faxxxan/WALL-B/src/modules/display/images/chatgpt_eye2.png

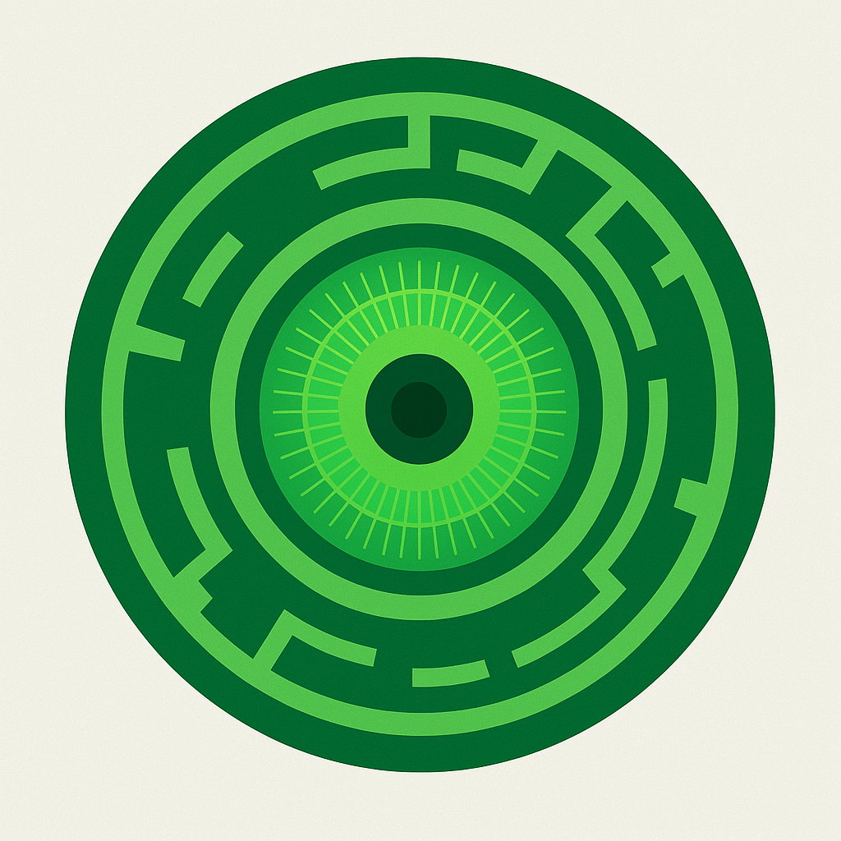
src/modules/display/images/chatgpt_eye2.png
