faxxxan/WALL-B/src/modules/display/images/chatgpt_eye3.png

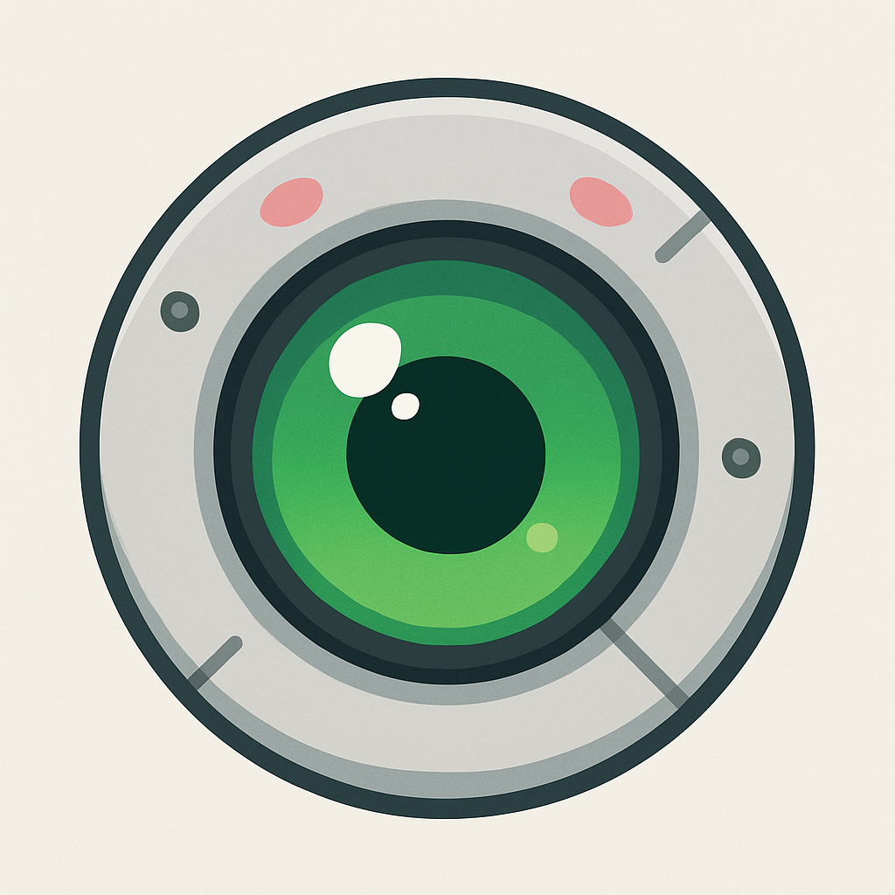
src/modules/display/images/chatgpt_eye3.png
