faxxxan/WALL-B/circuits/archie/Lower/Lower Feb 2021_pcb.png

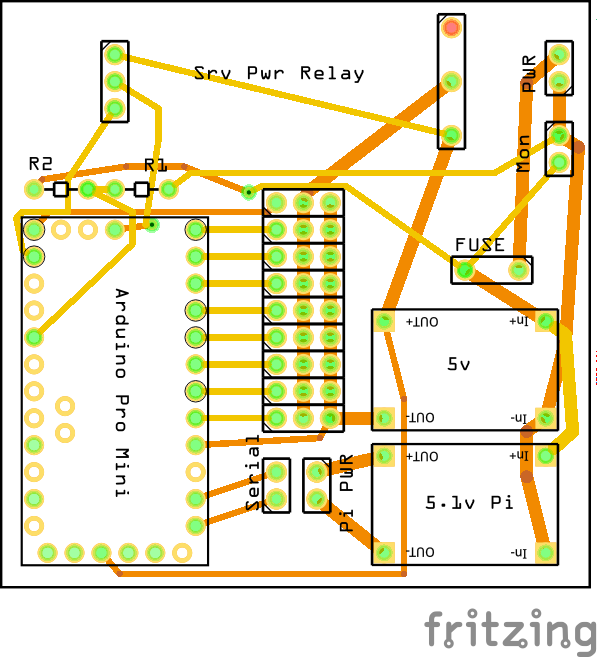
circuits/archie/Lower/Lower Feb 2021_pcb.png
