faxxxan/WALL-B/circuits/archie/Lower/Screenshot 2021-02-15 at 19.20.31.png

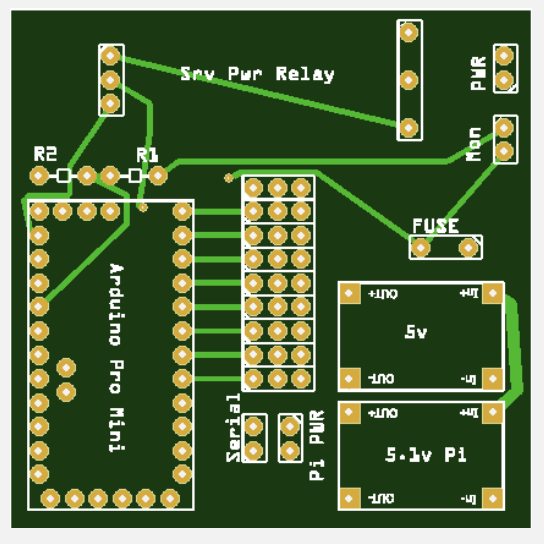
circuits/archie/Lower/Screenshot 2021-02-15 at 19.20.31.png
