faxxxan/WALL-B/circuits/archie/Upper/Screenshot 2021-02-15 at 19.52.01.png

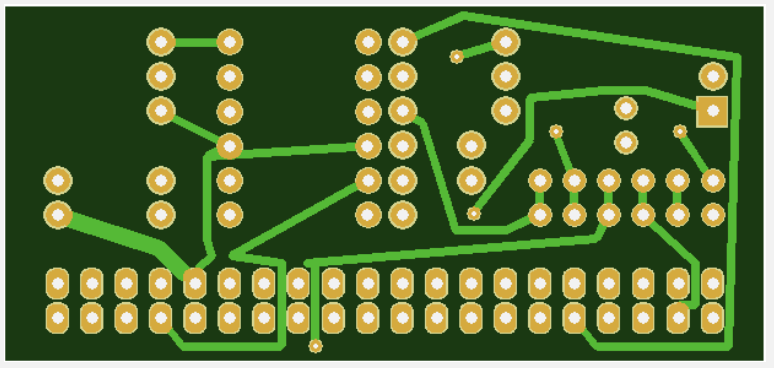
circuits/archie/Upper/Screenshot 2021-02-15 at 19.52.01.png
