faxxxan/WALL-B/circuits/archie/Upper/Top Feb 2021_pcb.png

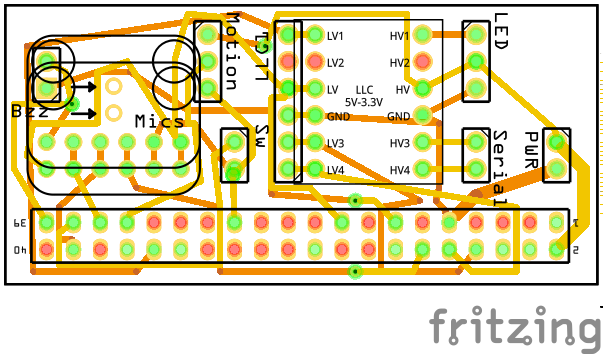
circuits/archie/Upper/Top Feb 2021_pcb.png
