faxxxan/WALL-B/circuits/buddy/body/body_pcb.png

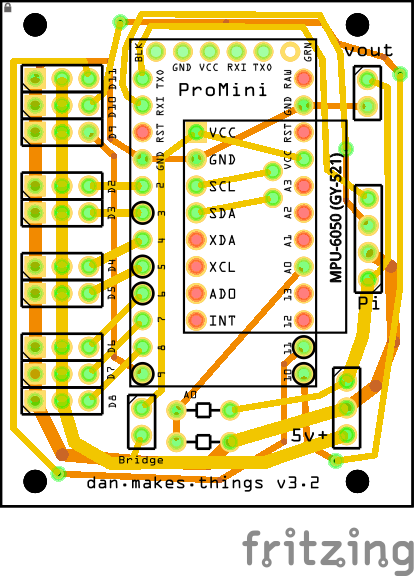
circuits/buddy/body/body_pcb.png
