faxxxan/WALL-B/circuits/buddy/head/head_schematic.png

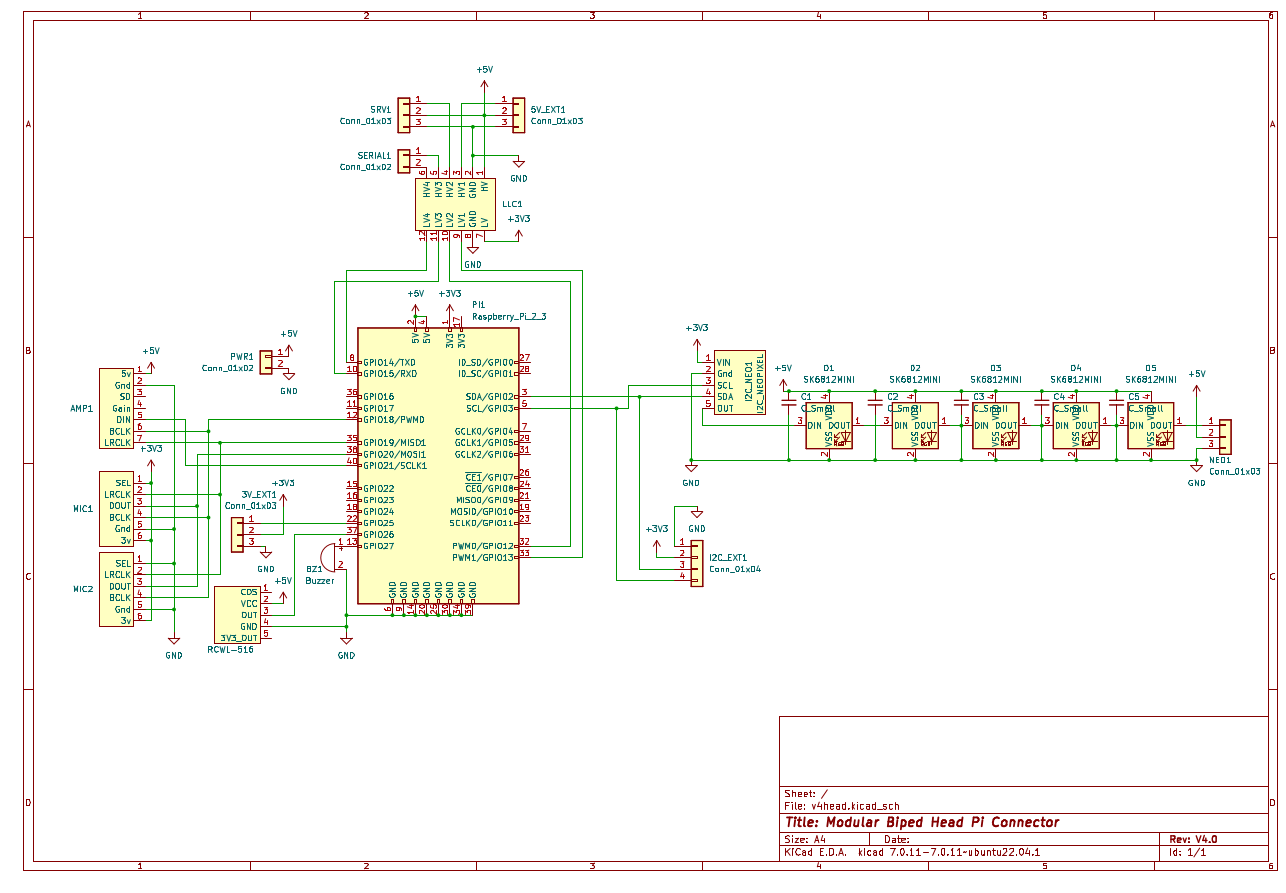
circuits/buddy/head/head_schematic.png
