faxxxan/WALL-B/images/d.jpeg

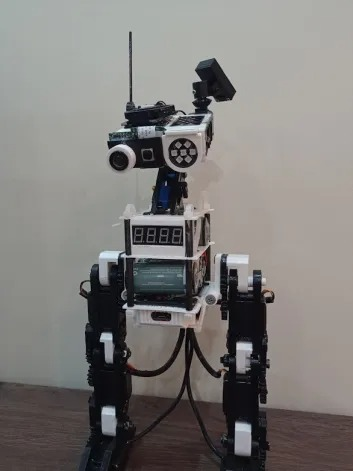
images/d.jpeg
