faxxxan/WALL-B/src/modules/display/images/chatgpt_eye1.png

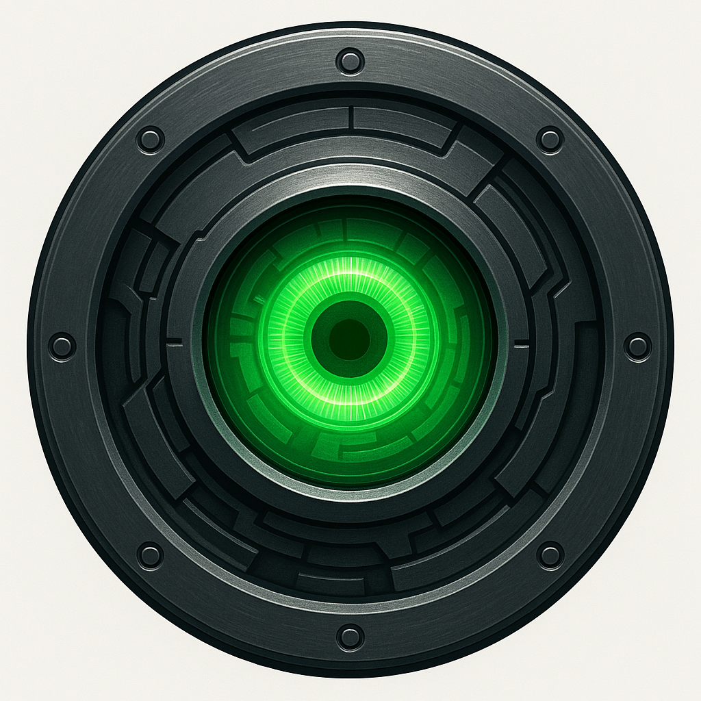
src/modules/display/images/chatgpt_eye1.png
