faxxxan/WALL-B/src/modules/display/images/chatgpt_eye4.png

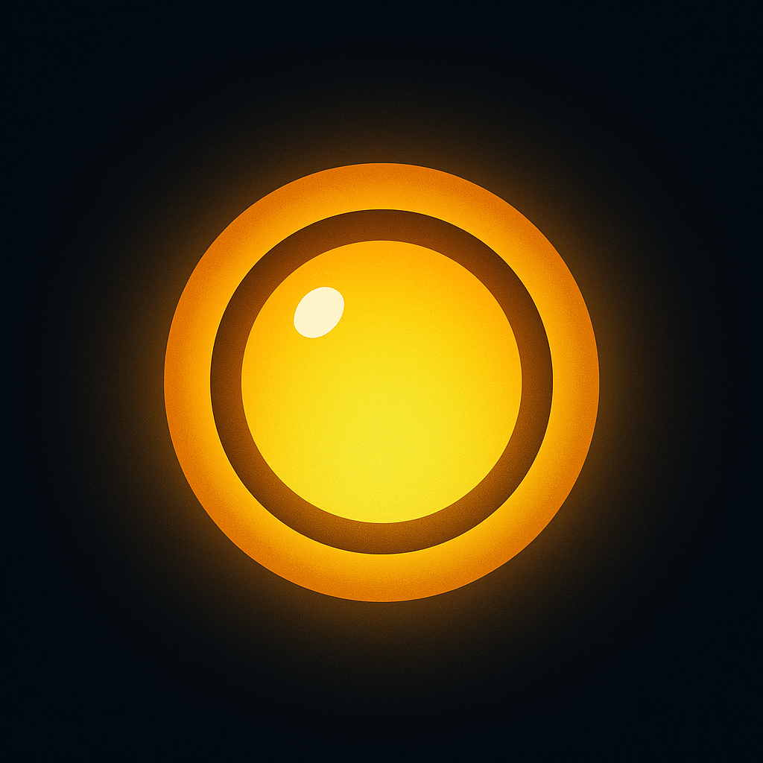
src/modules/display/images/chatgpt_eye4.png
