faxxxan/WALL-B/user_input_files/image.png

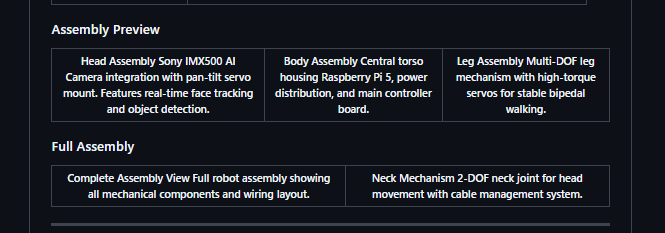
user_input_files/image.png
