faxxxan/WALL-B/3d_prints/archie/Complete (Reference).stl

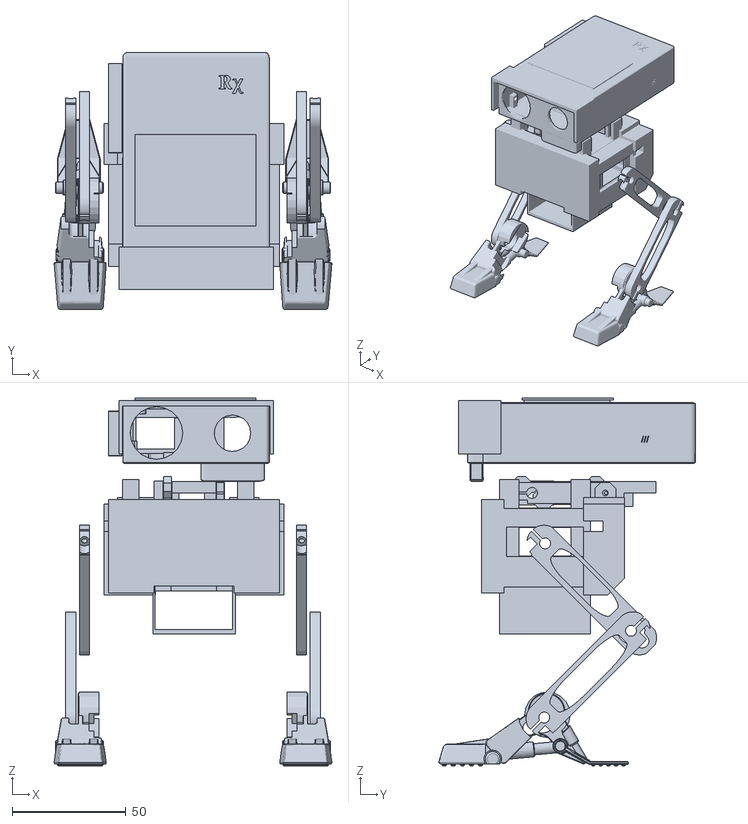
[picture p15: CAD file, 2026-03-01]
3d_prints/archie/Complete (Reference).stl
122.0 x 112.7 x 161.6
