faxxxan/WALL-B/3d_prints/archie/Archie - Head Lid.stl

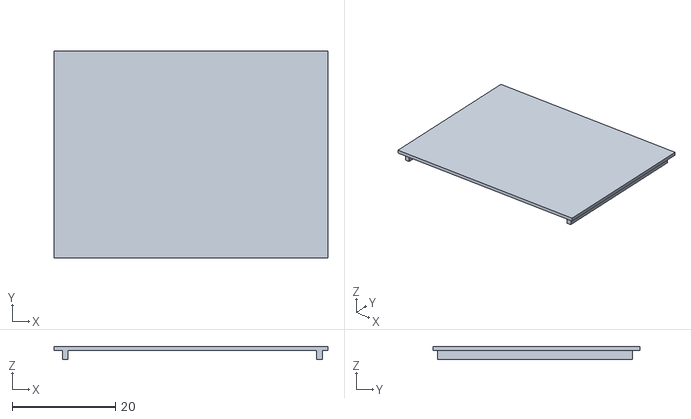
[picture p16: CAD file, 2026-03-01]
3d_prints/archie/Archie - Head Lid.stl
53.1 x 40.2 x 2.60
