faxxxan/WALL-B/3d_prints/archie/Archie - Foot Left.stl

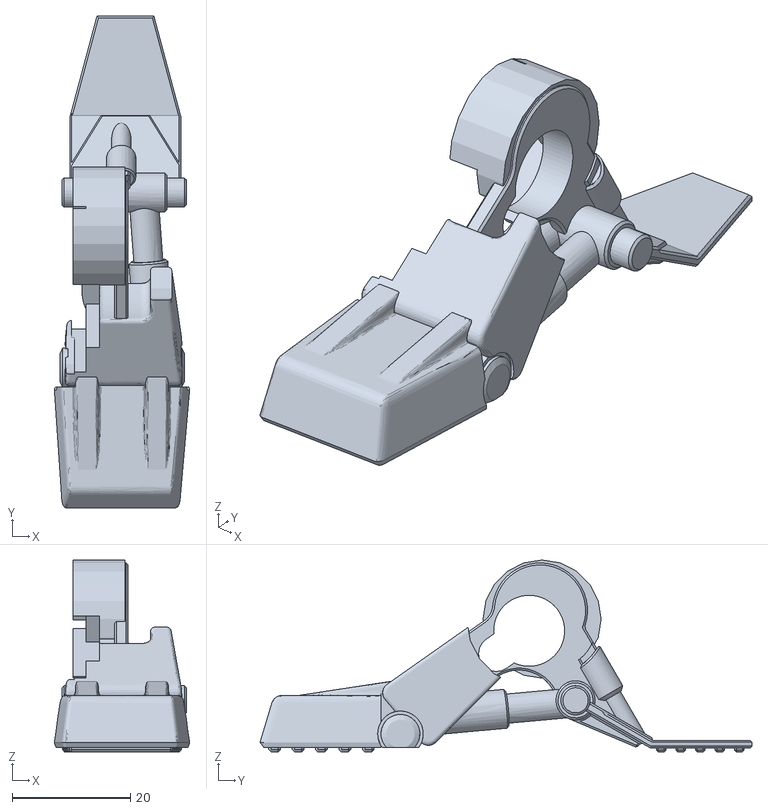
[picture p17: CAD file, 2026-03-01]
3d_prints/archie/Archie - Foot Left.stl
22.9 x 83.3 x 32.5
