faxxxan/WALL-B/3d_prints/archie/Archie - Head Top.stl

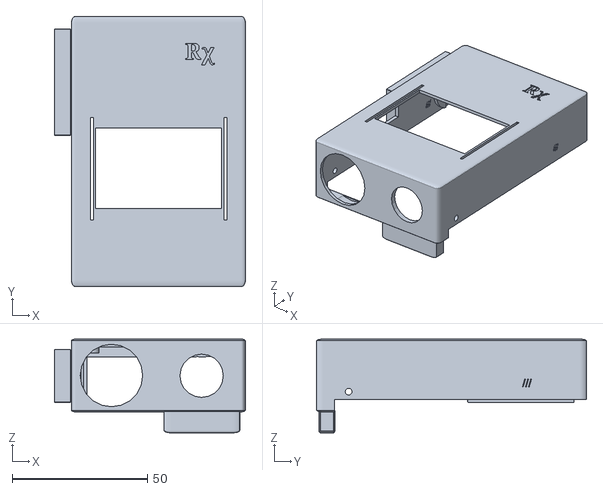
[picture p18: CAD file, 2026-03-01]
3d_prints/archie/Archie - Head Top.stl
70.6 x 100.0 x 34.7
