faxxxan/WALL-B/3d_prints/archie/Archie - Body Skeleton.stl

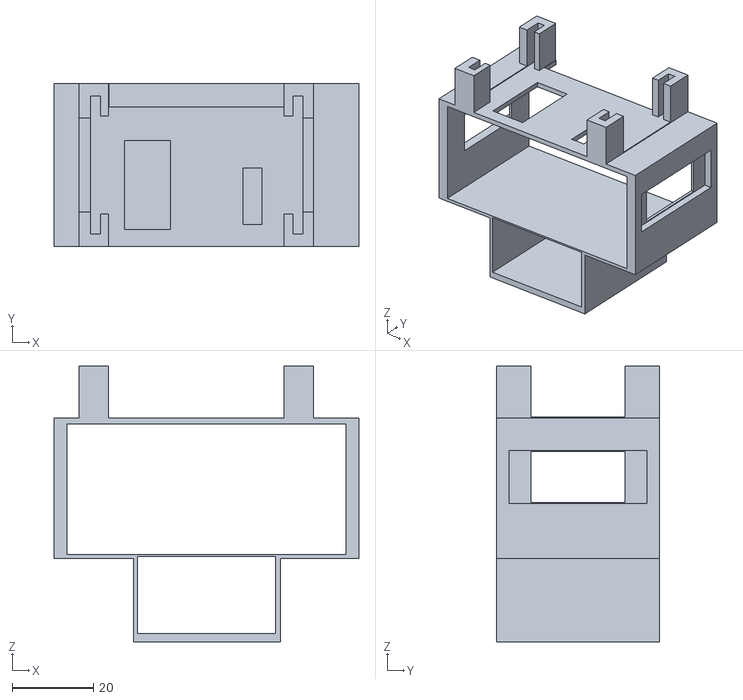
[picture p19: CAD file, 2026-03-01]
3d_prints/archie/Archie - Body Skeleton.stl
75.0 x 40.0 x 67.8
