faxxxan/WALL-B/3d_prints/archie/Archie - Neck Tilt Mount.stl

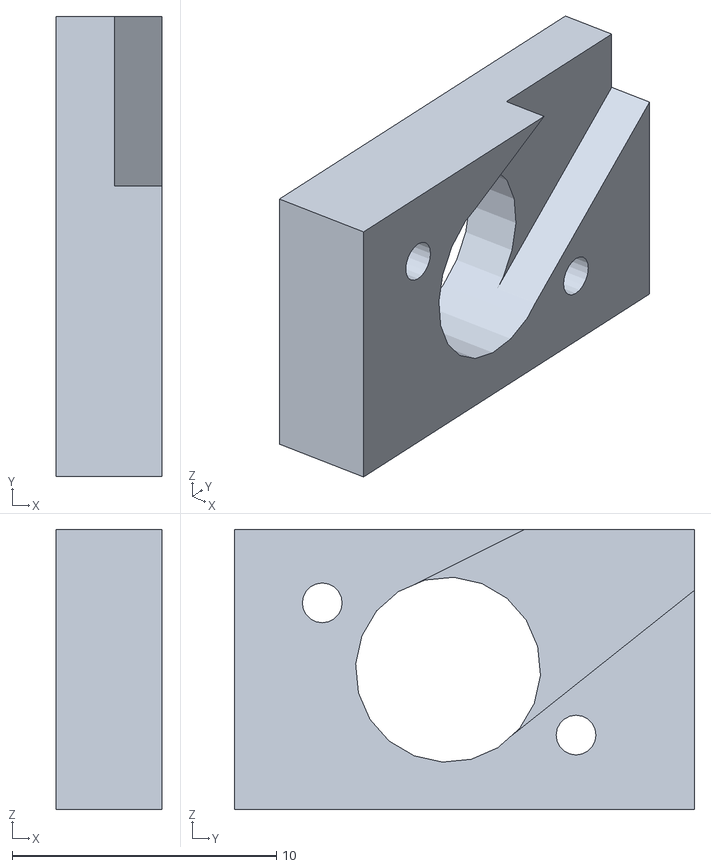
[picture p20: CAD file, 2026-03-01]
3d_prints/archie/Archie - Neck Tilt Mount.stl
4.00 x 17.4 x 10.6
