faxxxan/WALL-B/3d_prints/archie/Archie - Neck Servo Mount.stl

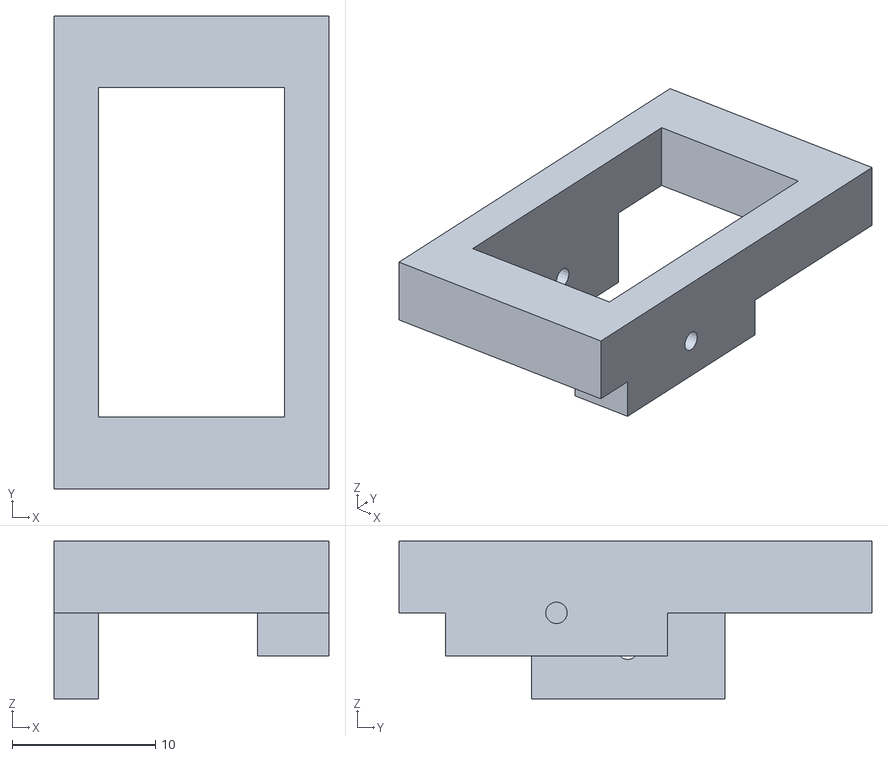
[picture p21: CAD file, 2026-03-01]
3d_prints/archie/Archie - Neck Servo Mount.stl
19.2 x 33.0 x 11.0
