faxxxan/WALL-B/3d_prints/archie/Archie - Head Visor.stl

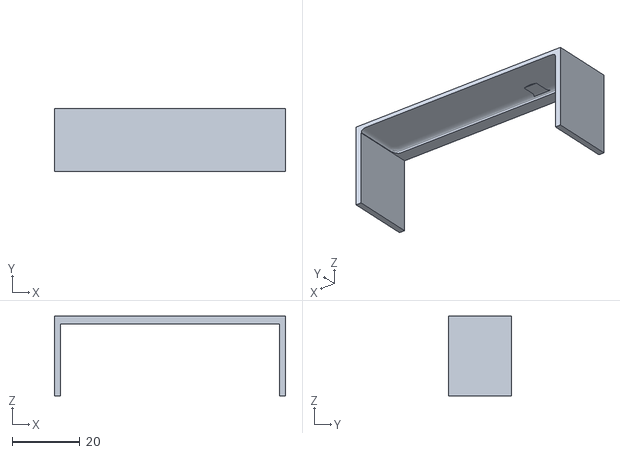
[picture p22: CAD file, 2026-03-01]
3d_prints/archie/Archie - Head Visor.stl
68.0 x 18.5 x 23.5
