faxxxan/WALL-B/3d_prints/archie/Archie - Neck Tilt Lower.stl

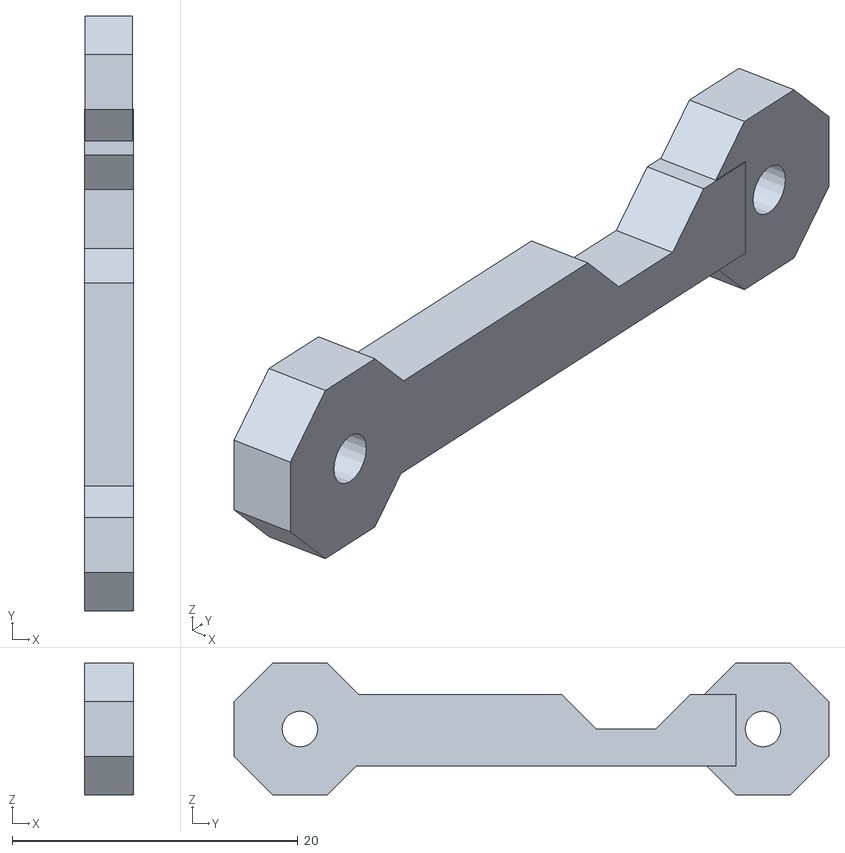
[picture p23: CAD file, 2026-03-01]
3d_prints/archie/Archie - Neck Tilt Lower.stl
3.40 x 41.7 x 9.24
