faxxxan/WALL-B/3d_prints/archie/Archie - Neck Tilt Upper.stl

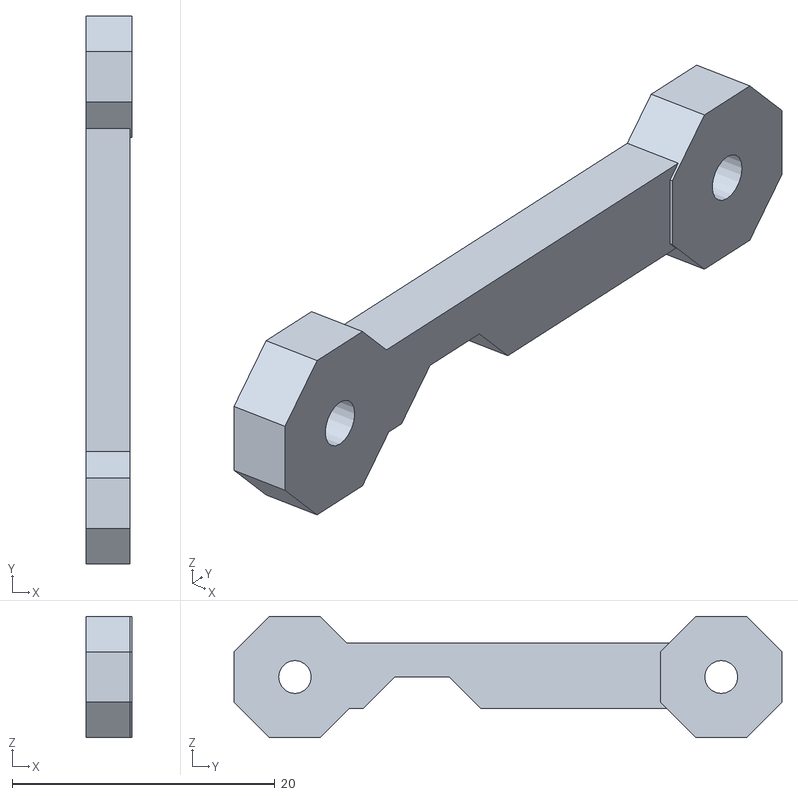
[picture p24: CAD file, 2026-03-01]
3d_prints/archie/Archie - Neck Tilt Upper.stl
3.50 x 41.7 x 9.24
