faxxxan/WALL-B/3d_prints/archie/Archie - Case Front.stl

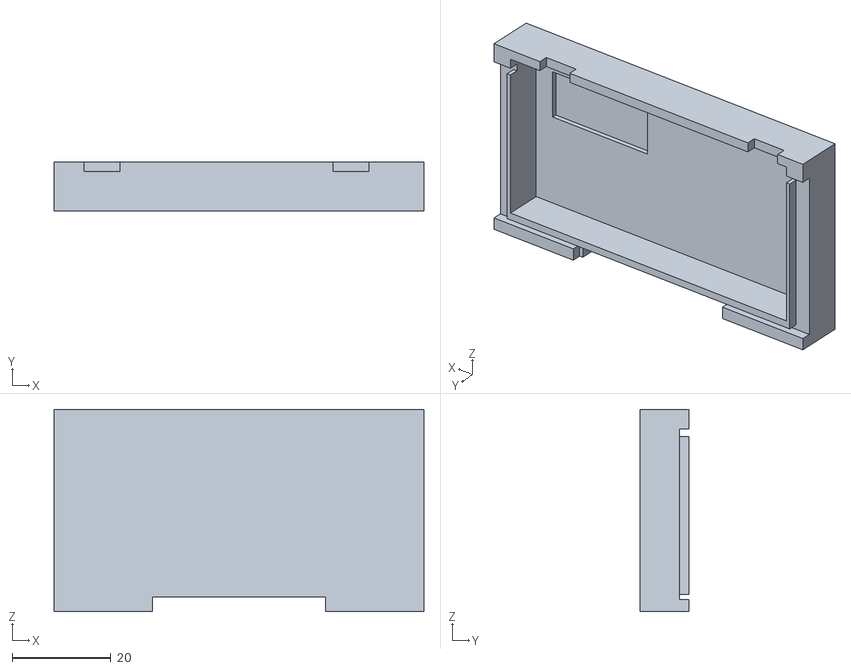
[picture p25: CAD file, 2026-03-01]
3d_prints/archie/Archie - Case Front.stl
75.0 x 10.0 x 41.0
