faxxxan/WALL-B/3d_prints/archie/Archie - Head Bottom.stl

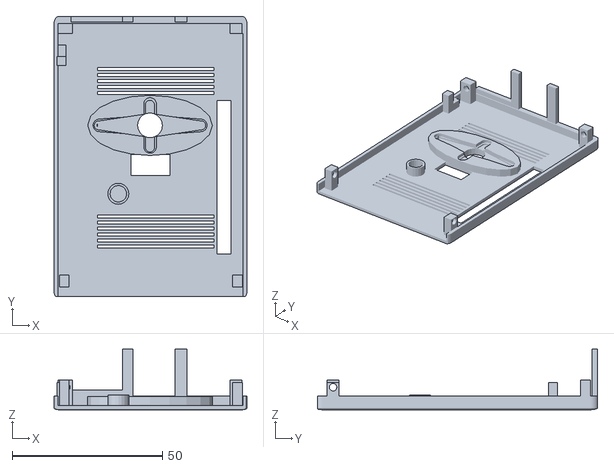
[picture p26: CAD file, 2026-03-01]
3d_prints/archie/Archie - Head Bottom.stl
64.2 x 93.2 x 20.1
