faxxxan/WALL-B/3d_prints/archie/Archie - Case Back.stl

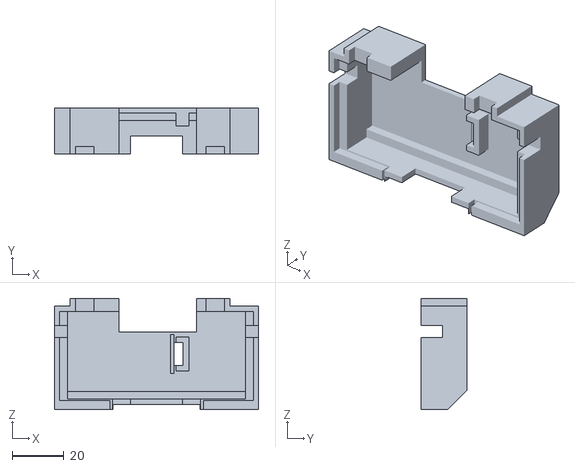
[picture p27: CAD file, 2026-03-01]
3d_prints/archie/Archie - Case Back.stl
79.0 x 18.0 x 43.0
