faxxxan/WALL-B/3d_prints/archie/Archie - Leg Lower.stl

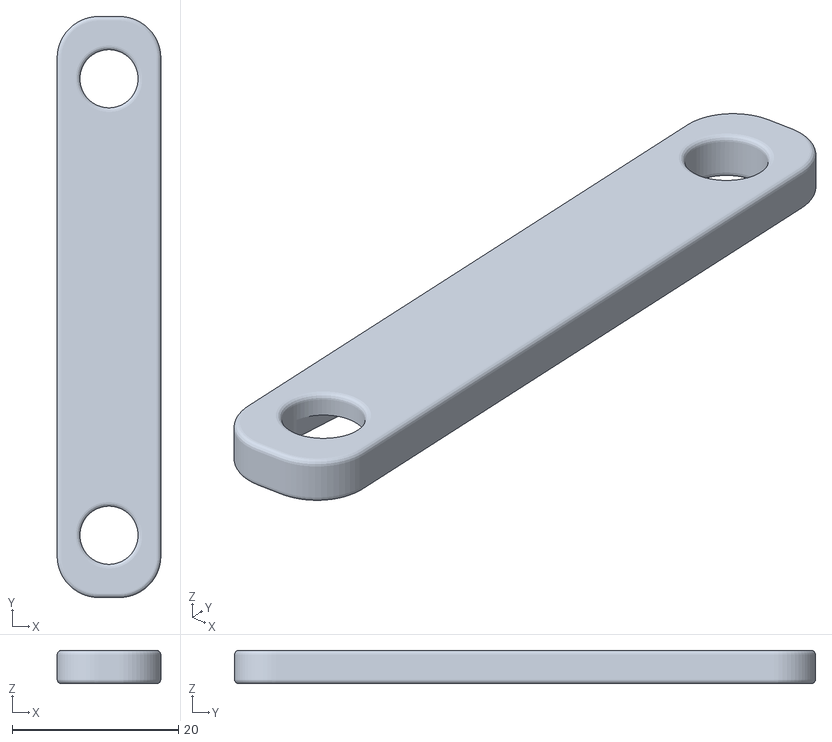
[picture p28: CAD file, 2026-02-08]
3d_prints/archie/Archie - Leg Lower.stl
12.5 x 70.0 x 4.00
