faxxxan/WALL-B/3d_prints/archie/Archie - Leg Upper.stl

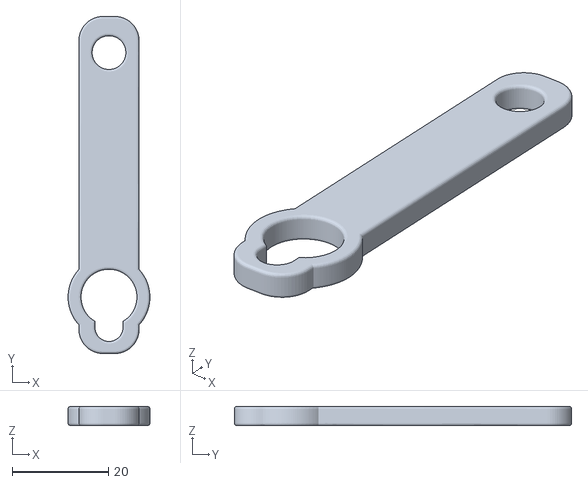
[picture p29: CAD file, 2026-02-08]
3d_prints/archie/Archie - Leg Upper.stl
17.0 x 70.0 x 4.00
