faxxxan/WALL-B/3d_prints/archie/Archie - Neck Extension.stl

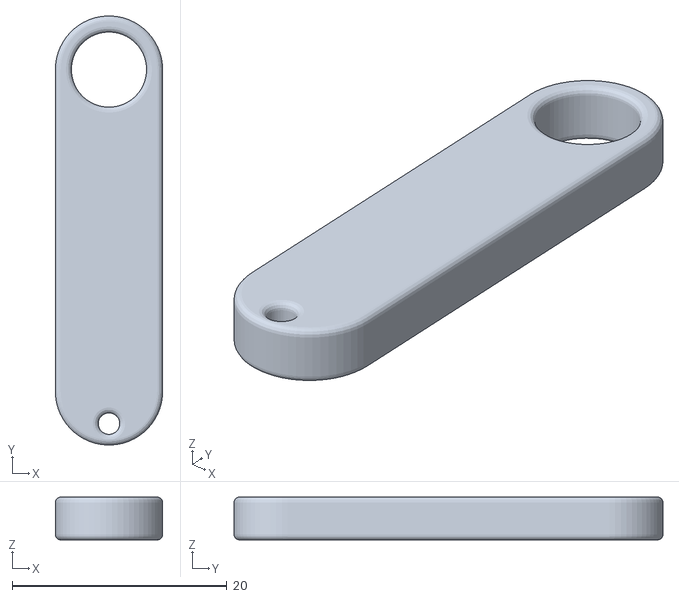
[picture p30: CAD file, 2026-02-08]
3d_prints/archie/Archie - Neck Extension.stl
10.0 x 40.0 x 4.00
