faxxxan/WALL-B/3d_prints/archie/archive/left_leg_upper.stl

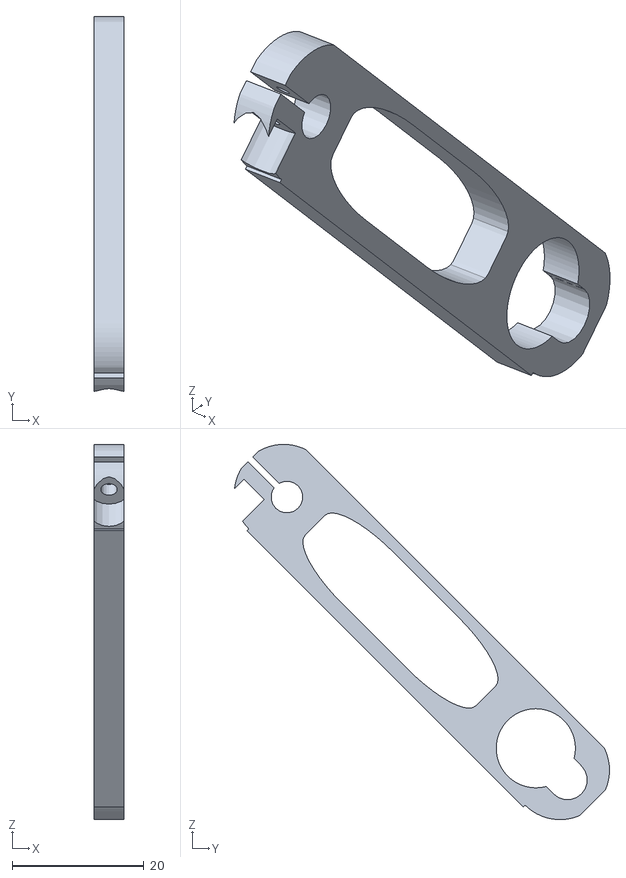
[picture p31: CAD file, 2026-03-01, an earlier design]
3d_prints/archie/archive/left_leg_upper.stl
4.50 x 56.9 x 56.9
