faxxxan/WALL-B/(list of files, cad)

Other CAD files:
3d_prints/archie/Archie - Foot Right.stl
3d_prints/archie/archive/left_leg_lower.stl
3d_prints/archie/archive/neck_extension.stl
3d_prints/archie/archive/right_leg_lower.stl
3d_prints/archie/archive/right_leg_upper.stl
