faxxxan/WALL-B/3d_prints/archie/Complete (Reference).png

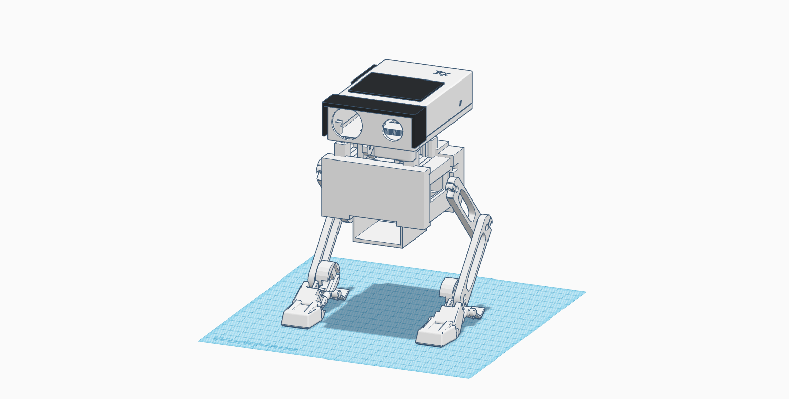
3d_prints/archie/Complete (Reference).png
