faxxxan/WALL-B/src/modules/display/images/makerforge.png

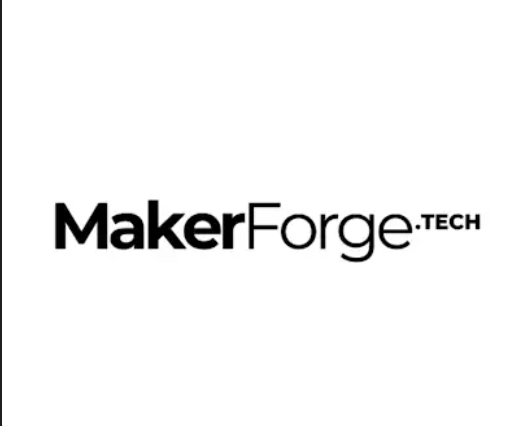
src/modules/display/images/makerforge.png
