faxxxan/WALL-B/src/modules/display/images/makerforge_bl.png

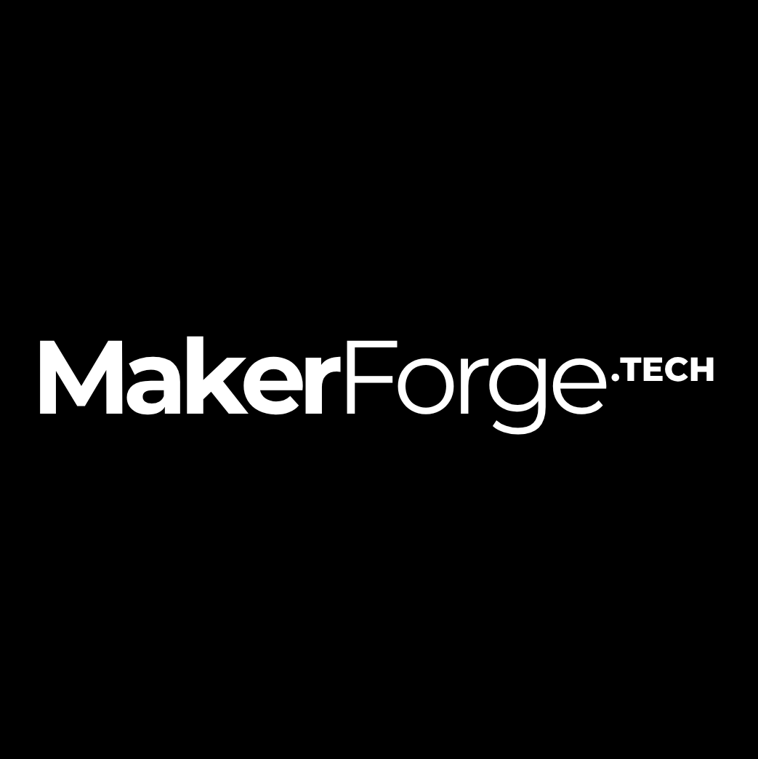
src/modules/display/images/makerforge_bl.png
