faxxxan/WALL-B/user_input_files/assembly_full.webp

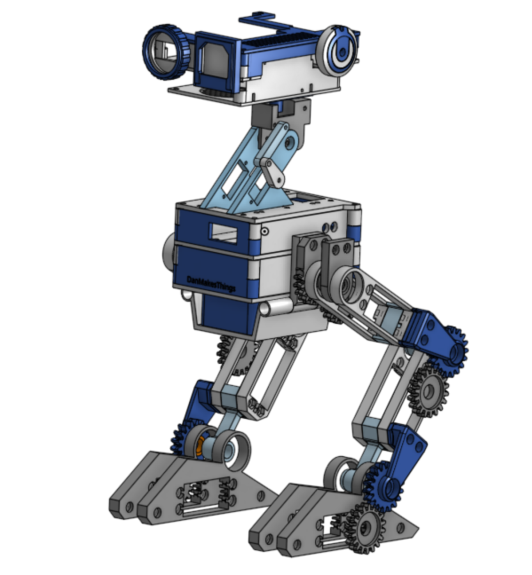
user_input_files/assembly_full.webp
