faxxxan/WALL-B/(list of files, drawings)

Other design files:
circuits/archie/Lower/Lower Feb 2021.fzz
circuits/archie/Upper/Top Feb 2021.fzz
circuits/buddy/archive/head/head.fzz
circuits/buddy/body/body.fzz
