faxxxan/WALL-B/circuits/buddy/head/v4head/v4head.kicad_pcb

## KiCad design circuits/buddy/head/v4head/v4head.kicad_pcb (2026-03-01)

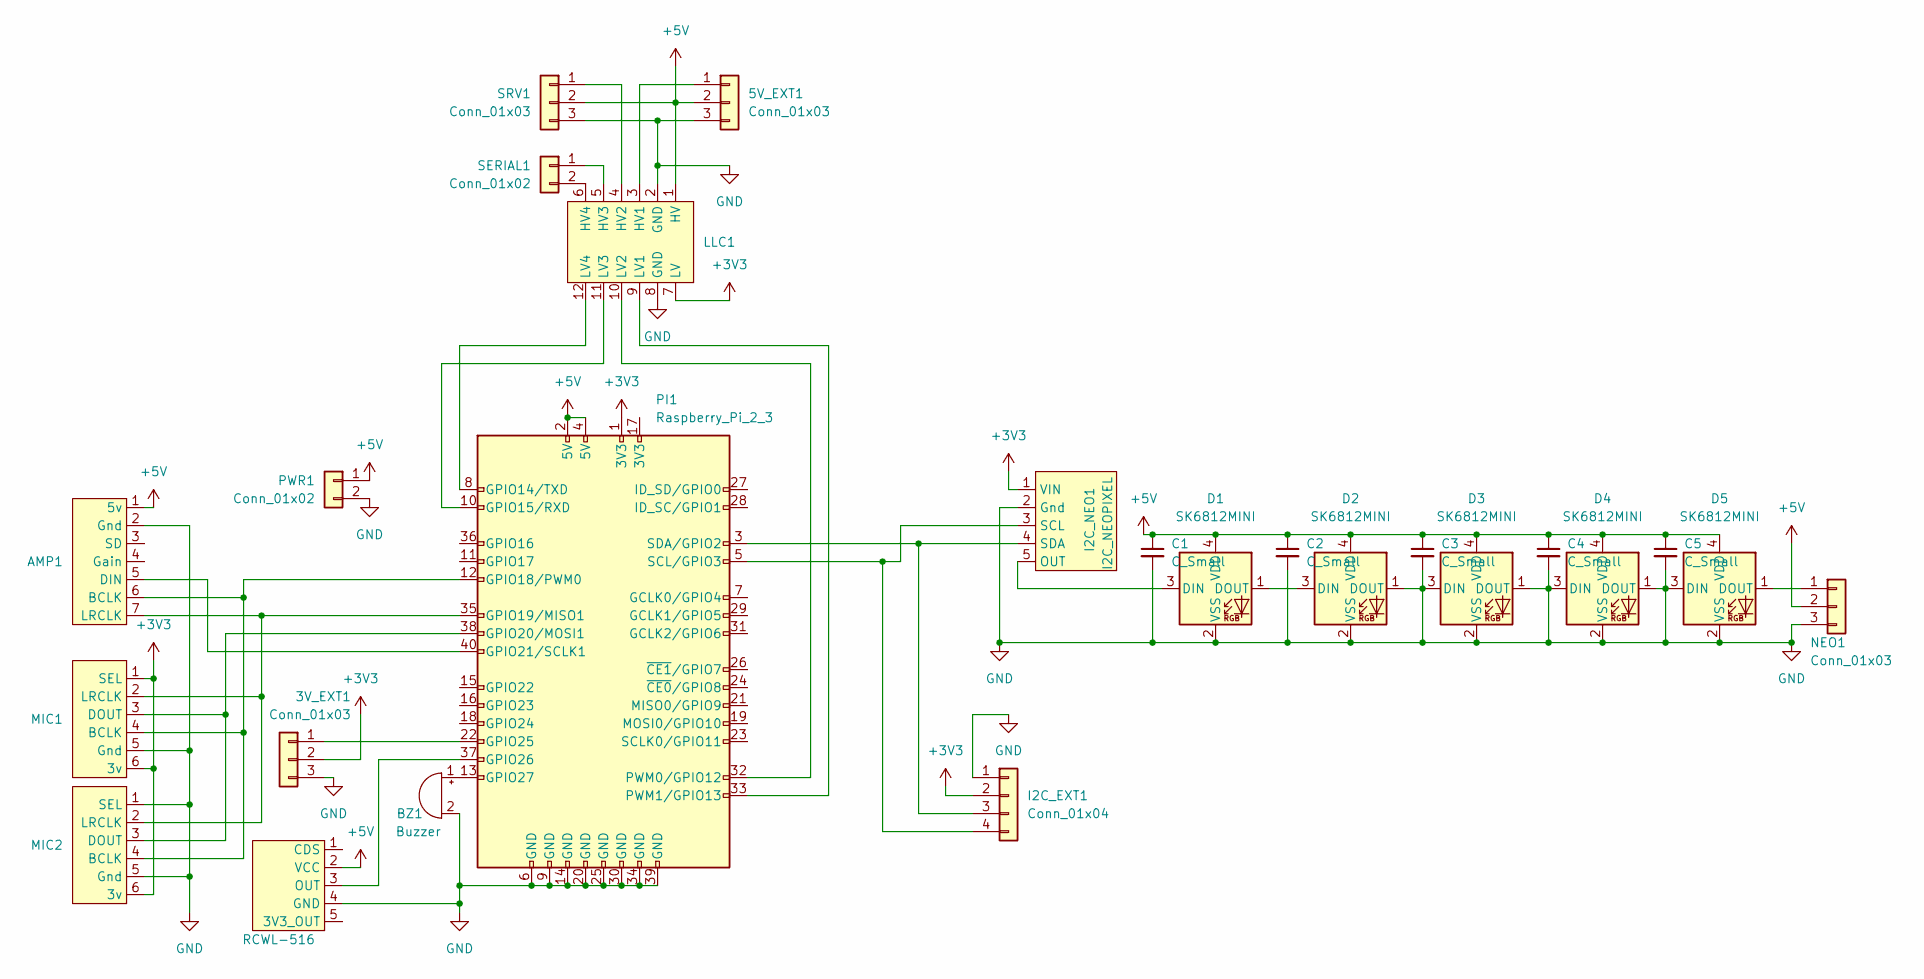
[picture p36: schematic v4head.kicad_sch, Modular Biped Head Pi Connector]

Parts:
3V_EXT1, 5V_EXT1: Conn_01x03; JST_XH_B3B-XH-A_1x03_P2.50mm_Vertical
AMP1: MAX98357
BZ1: Buzzer; Buzzer_12x9.5RM7.6
C1, C2, C3, C4, C5: C_Small; C_0201_0603Metric
D1, D2, D3, D4, D5: SK6812MINI; LED_SK6812MINI_PLCC4_3.5x3.5mm_P1.75mm
I2C_EXT1: Conn_01x04; JST_XH_B4B-XH-A_1x04_P2.50mm_Vertical
I2C_NEO1: I2C_NEOPIXEL
LLC1: LCC_BIDIRECTIONAL
MIC1, MIC2: SPH0645LM4H
NEO1: Conn_01x03; JST_XH_B3B-XH-A_1x03_P2.50mm_Vertical
PI1: Raspberry_Pi_2_3; PinHeader_2x20_P2.54mm_Vertical
PWR1: Conn_01x02; JST_XH_B2B-XH-A_1x02_P2.50mm_Vertical
RCWL-516: RCWL-0516_MIN
SERIAL1: Conn_01x02; JST_XH_B2B-XH-A_1x02_P2.50mm_Vertical
SRV1: Conn_01x03; PinHeader_1x03_P2.54mm_Vertical

Connections:
+3V3: 3V_EXT1.2, I2C_EXT1.2, I2C_NEO1.1 (VIN), LLC1.7 (LV), MIC1.1 (SEL), MIC1.6 (3v), MIC2.6 (3v), PI1.1 (3V3)
+5V: 5V_EXT1.2, AMP1.1 (5v), C1.1, C2.1, C3.1, C4.1, C5.1, D1.4 (VDD), D2.4 (VDD), D3.4 (VDD), D4.4 (VDD), D5.4 (VDD), LLC1.1 (HV), NEO1.2, PI1.2 (5V), PI1.4 (5V), PWR1.1, RCWL-516.2 (VCC), SRV1.2
GND: 3V_EXT1.3, 5V_EXT1.3, AMP1.2 (Gnd), BZ1.2 (+), C1.2, C2.2, C3.2, C4.2, C5.2, D1.2 (VSS), D2.1 (DOUT), D2.2 (VSS), D3.1 (DOUT), D3.2 (VSS), D3.3 (DIN), D4.1 (DOUT), D4.2 (VSS), D4.3 (DIN), D5.2 (VSS), D5.3 (DIN), I2C_EXT1.1, I2C_NEO1.2 (Gnd), LLC1.2 (GND), LLC1.8 (GND), MIC1.5 (Gnd), MIC2.1 (SEL), MIC2.5 (Gnd), NEO1.3, PI1.6 (GND), PI1.9 (GND), PI1.14 (GND), PI1.20 (GND), PI1.25 (GND), PI1.30 (GND), PI1.34 (GND), PI1.39 (GND), PWR1.2, RCWL-516.4 (GND), SRV1.3
unnamed: 3V_EXT1.1, PI1.22 (GPIO25)
unnamed: 5V_EXT1.1, LLC1.3 (HV1)
unnamed: AMP1.6 (BCLK), MIC1.4 (BCLK), MIC2.4 (BCLK), PI1.12 (GPIO18/PWM0)
unnamed: AMP1.5 (DIN), PI1.40 (GPIO21/SCLK1)
unnamed: AMP1.7 (LRCLK), MIC1.2 (LRCLK), MIC2.2 (LRCLK), PI1.35 (GPIO19/MISO1)
unnamed: BZ1.1 (-), PI1.13 (GPIO27)
unnamed: D1.3 (DIN), I2C_NEO1.5 (OUT)
unnamed: D1.1 (DOUT), D2.3 (DIN)
unnamed: D5.1 (DOUT), NEO1.1
unnamed: I2C_EXT1.3, I2C_NEO1.4 (SDA), PI1.3 (SDA/GPIO2)
unnamed: I2C_EXT1.4, I2C_NEO1.3 (SCL), PI1.5 (SCL/GPIO3)
unnamed: LLC1.4 (HV2), SRV1.1
unnamed: LLC1.5 (HV3), SERIAL1.1
unnamed: LLC1.6 (HV4), SERIAL1.2
unnamed: LLC1.9 (LV1), PI1.33 (PWM1/GPIO13)
unnamed: LLC1.10 (LV2), PI1.32 (PWM0/GPIO12)
unnamed: LLC1.11 (LV3), PI1.10 (GPIO15/RXD)
unnamed: LLC1.12 (LV4), PI1.8 (GPIO14/TXD)
unnamed: MIC1.3 (DOUT), MIC2.3 (DOUT), PI1.38 (GPIO20/MOSI1)
unnamed: PI1.37 (GPIO26), RCWL-516.3 (OUT)

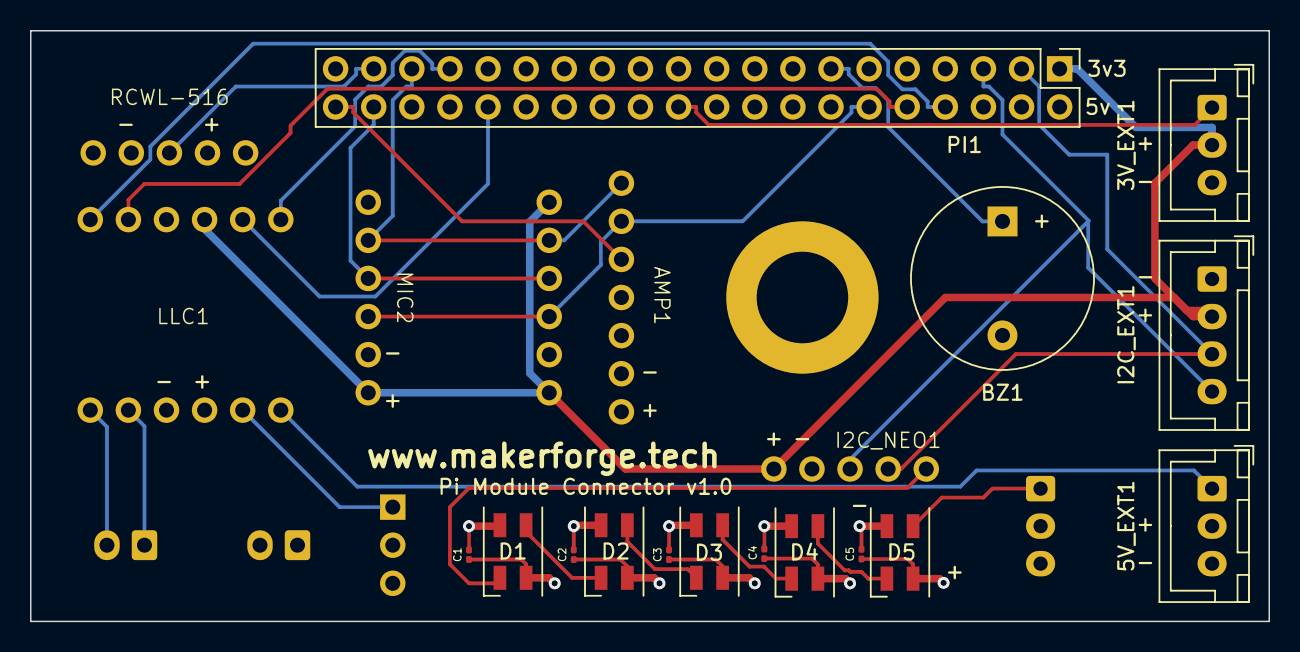
[picture p37: board v4head.kicad_pcb from above]

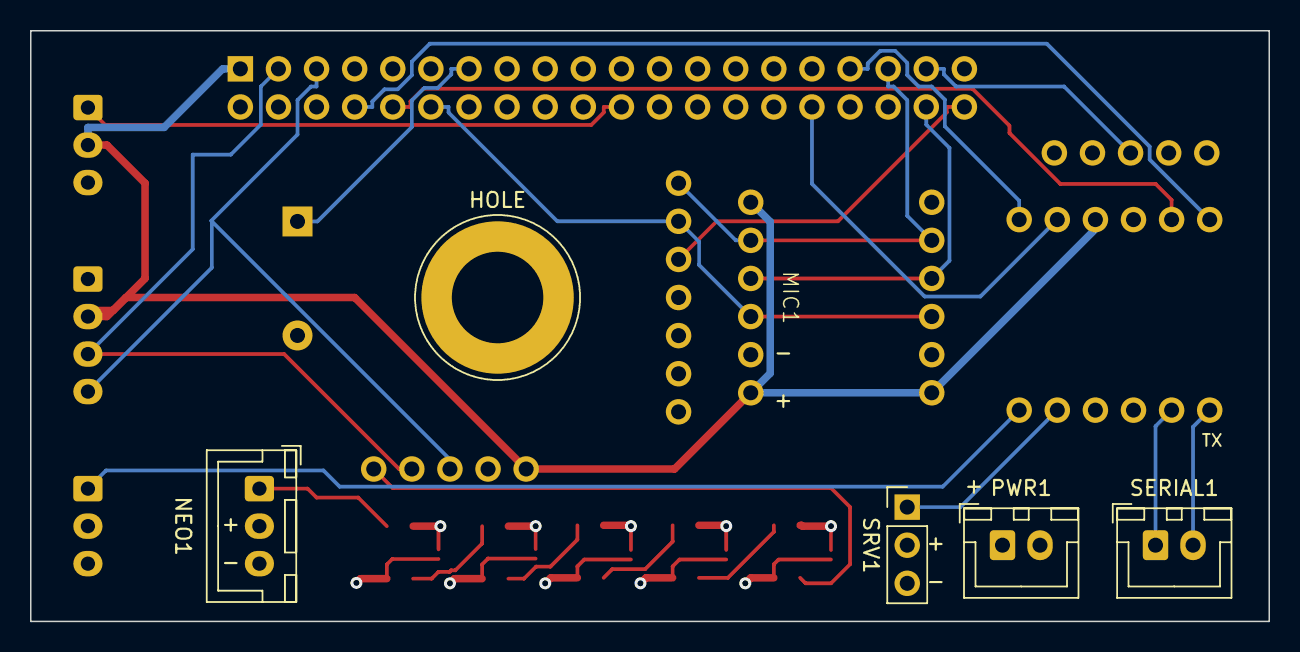
[picture p38: board v4head.kicad_pcb from below]

Board: 4 copper layers, 82.5 x 39.4 mm, 26 parts (6 on the bottom side), 23 nets.

Other parts of the board:
HOLE: Banana_Jack_1Pin
