faxxxan/WALL-B/(commit log)

2025-04-04 Added hip actuators
    [servos.yml]
2025-04-04 Fixing servo config
    [servos.yml]
2025-04-04 Adjust servos
2025-04-09 Working prototype of eye animation. To refactor.
2025-04-10 Working camera and TFT Eye
    [piservo.yml, servos.yml]
2025-05-31 Added CM5 Head Wiring.drawio
2025-05-31 Update CM5 Head Wiring.drawio
2025-07-12 WIP bus servo management
2025-07-12 Update config
    [servo_waveshare.yml]
2025-07-13 Added SC servo examples + compatibility
    [servo_waveshare.yml]
2025-07-14 Configure initial positions
    [servo_waveshare.yml]
2025-07-14 Allow other poses to be stored and accessed
    [servo_waveshare.yml]
2025-10-04 Calibrate servos on boot
    [servo_waveshare.yml]
2025-10-05 Dynamic servo calibration + center on change_id
2025-12-13 Controller support and WIP recording
    [controller.yml, piservo.yml, servo_bus.yml, servo_waveshare.yml]
2025-12-13 Working with Pi
    [controller.yml]
2025-12-13 Adjust config
    [controller.yml]
2025-12-14 Support servo control (WIP - calibration needed)
    [controller.yml, servo_bus.yml]
2025-12-15 Callibration + allow modules to be disabled on test environments
    [controller.yml, servo_bus.yml]
2025-12-17 Calibrate new leg position
    [controller.yml, servo_bus.yml]
2025-12-18 Improvements to gamepad controller modules. Temperature alert in display.
    [controller.yml, controller_handler.yml]
2025-12-21 Fixes and improvements to loop and temperature management
    [controller_handler.yml]
2026-01-16 Update servo config
    [servo_bus.yml]
2026-01-24 Testing neck mechanism
    [controller_handler.yml, servo_bus.yml]
2026-01-24 Disable servo test
2026-02-08 Added 2026 updates to leg and neck
    [Archie - Leg Lower.stl, Archie - Leg Upper.stl, Archie - Neck Tilt.stl]
2026-02-12 Dual BNO055, Servo improvements
    [servo_bus.yml]
2026-02-13 Updates + fixed telegram
    [servo_bus.yml]
2026-02-16 WIP servo balance
2026-02-16 New leg configuration. Fixed crashing
    [servo_bus.yml]
2026-02-17 Balance on tilt
    [servo_bus.yml]
2026-02-19 Adjusted servos and vision
    [servo_bus.yml]
2026-02-20 Adjust servos + fix autolaunch
    [servo_bus.yml]
2026-02-21 Add chicken head
    [servo_bus.yml]
2026-02-24 Added pose estimation, preset poses and 'wait while moving'. Need to add queue rather than sleep
    [servo_bus.yml]
2026-02-24 Add non-blocking move queue to bus servo
    - Add _move_queue (collections.deque) to Servo.__init__
    - Add queue_move(position, speed, acceleration, delay) method that enqueues a move with timestamp
    - Add process_queue() subscribed to system/loop; executes next item when servo is idle and delay has elapsed
    - Remove blocking while/sleep loop from move()
    - Remove blocking time.sleep() from move_degrees()
    - Add optional speed/acceleration params to move()
    - Change servo:{id}:mvabs subscription to use queue_move
    - Add servo:{id}:queue topic also routed to queue_move
    - Add 17 unit tests in modules/actuators/tests/bus_servo_test.py
2026-02-25 Callibrate and fix bugs
    [servo_bus.yml]
2026-02-25 Restructure modules into self-contained directories with config, docs, and tests
    [controller.yml, controller_handler.yml, i2c_servo.yml, piservo.yml, servos.yml]
2026-02-28 Add per-device environment configs, update module_loader and autolaunch.sh
2026-03-01 Migrate docs+tests to modules; create src/; move environments/ to root; fix env configs
    [buddy.yml, bus_servo.py, bus_servo_test.py, change_id.py, cody.yml]
2026-03-01 Restructure and readme
    [Lower Feb 2021.fzz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]
2026-03-01 Configuration and test fixes
    [buddy.yml, cody.yml]
2026-04-09 feat: Improve WALL-B repository with comprehensive documentation and CI
    Major improvements:
    - Fixed README.md with consistent WALL-B naming and branding
    - Added GitHub badges (stars, forks, issues, last commit, CI)
    - Fixed broken git clone command
    - Replaced 'Dobby_control' with 'wallb_control' launch command
    - Removed placeholder lines
    New documentation files:
    - docs/assembly.md: Complete assembly guide with tools, parts, step-by-step
    - docs/electronics.md: Wiring diagrams and pin mappings for all 22 servos
    - docs/software.md: Software setup guide including ROS2 and Arduino
    - docs/troubleshooting.md: Common issues and solutions
    New GitHub features:
    - .github/workflows/ci.yml: GitHub Actio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
2026-04-09 docs: Add real robot images to README
    - Replace placeholder image with actual WALL-B robot photos
    - Add assembly preview images (head, body, leg)
    - Add full assembly and neck mechanism images
    - Improve visual appeal and showcase actual project
    Images used:
    - full_project_front_pi5.jpg (main hero image)
    - assembly_head.png
    - assembly_body.png
    - assembly_leg.png
    - assembly_full.png
    - assembly_neck.png
